lukasHD/74hc595/Board/jlcpcb/production_files/BOM-test_sr.csv

Comment | Designator | Footprint | LCSC
100n | C1,C2,C3 | C_0603_1608Metric | C14663
50R | R1,R2,R3,R4,R5,R6,R7,R8 | R_0603_1608Metric | C23197
10k | R10,R9 | R_0603_1608Metric | C25804
74HC595 | U1 | SOIC-16_4.55x10.3mm_P1.27mm | C5947
LED | D1,D2,D3,D4,D5,D6,D7,D8 | LED_0603_1608Metric | C72041
Conn_01x08 | J2 | PinHeader_1x08_P2.54mm_Vertical
Conn_01x08 | J1 | PinHeader_1x08_P2.54mm_Vertical
