lukasHD/74hc595/Board/test_sr.kicad_pcb

## KiCad design Board/test_sr.kicad_pcb (2023-10-25)

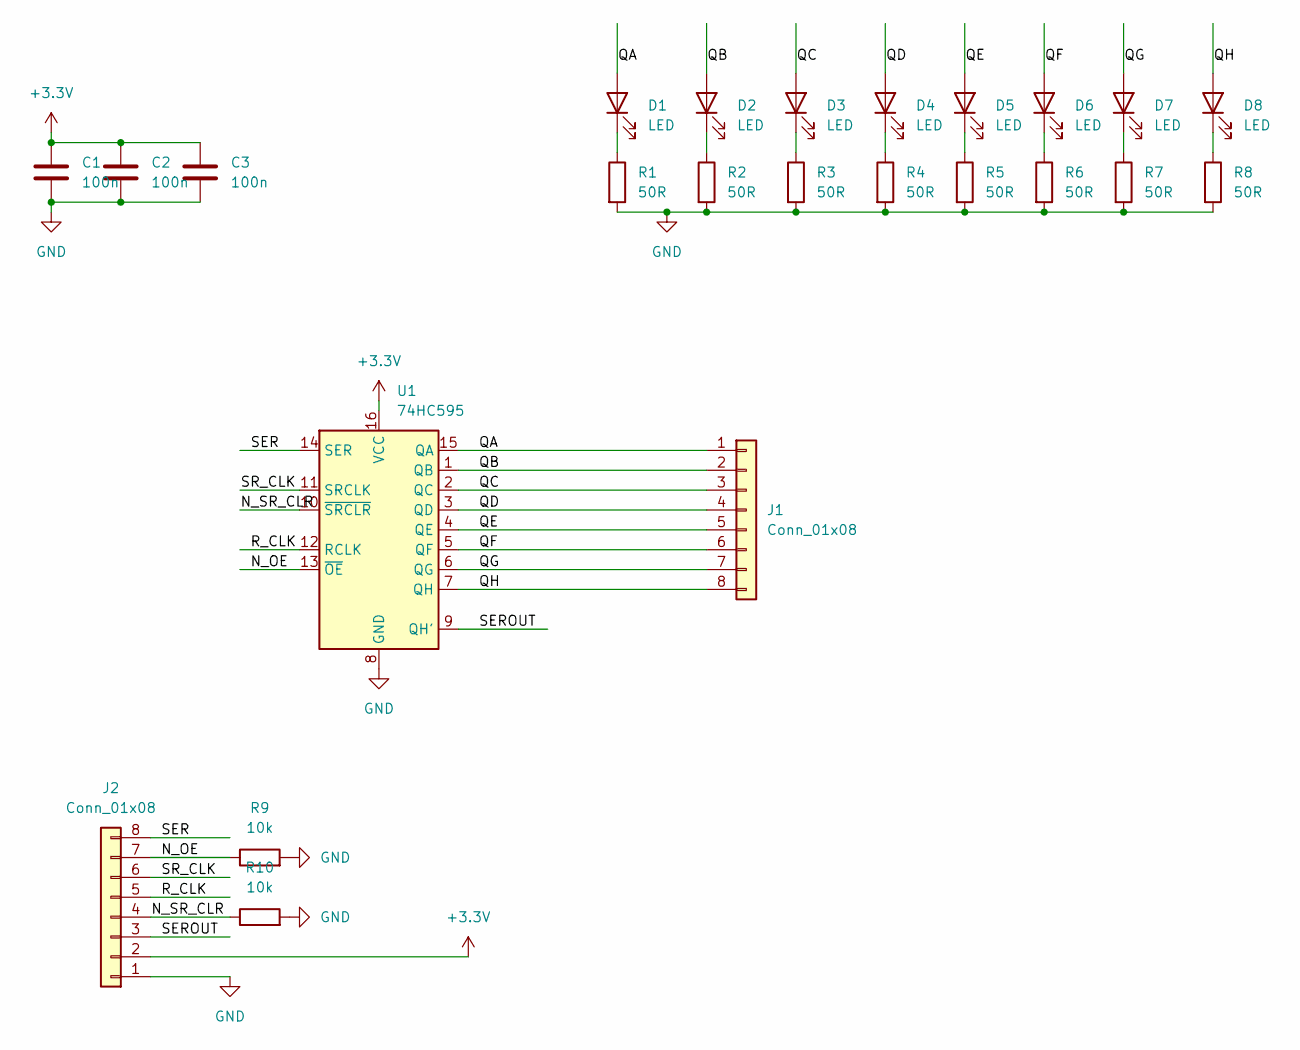
[picture p2: schematic test_sr.kicad_sch]

Parts:
C1, C2, C3: 100n; C_0603_1608Metric; LCSC C14663
D1, D2, D3, D4, D5, D6, D7, D8: LED; LED_0603_1608Metric; LCSC C72041
J1, J2: Conn_01x08; PinHeader_1x08_P2.54mm_Vertical
R1, R2, R3, R4, R5, R6, R7, R8: 50R; R_0603_1608Metric; LCSC C23197
R9, R10: 10k; R_0603_1608Metric; LCSC C25804
U1: 74HC595; SOIC-16_4.55x10.3mm_P1.27mm; LCSC C5947

Connections:
+3.3V: C1.1, C2.1, C3.1, J2.2, U1.16 (VCC)
/N_OE: J2.7, R9.1, U1.13 (~OE)
/N_SR_CLR: J2.4, R10.1, U1.10 (~SRCLR)
/QA: D1.2 (A), J1.1, U1.15 (QA)
/QB: D2.2 (A), J1.2, U1.1 (QB)
/QC: D3.2 (A), J1.3, U1.2 (QC)
/QD: D4.2 (A), J1.4, U1.3 (QD)
/QE: D5.2 (A), J1.5, U1.4 (QE)
/QF: D6.2 (A), J1.6, U1.5 (QF)
/QG: D7.2 (A), J1.7, U1.6 (QG)
/QH: D8.2 (A), J1.8, U1.7 (QH)
/R_CLK: J2.5, U1.12 (RCLK)
/SER: J2.8, U1.14 (SER)
/SEROUT: J2.3, U1.9 (QH')
/SR_CLK: J2.6, U1.11 (SRCLK)
GND: C1.2, C2.2, C3.2, J2.1, R1.2, R2.2, R3.2, R4.2, R5.2, R6.2, R7.2, R8.2, R9.2, R10.2, U1.8 (GND)
unnamed: D1.1 (K), R1.1
unnamed: D2.1 (K), R2.1
unnamed: D3.1 (K), R3.1
unnamed: D4.1 (K), R4.1
unnamed: D5.1 (K), R5.1
unnamed: D6.1 (K), R6.1
unnamed: D7.1 (K), R7.1
unnamed: D8.1 (K), R8.1

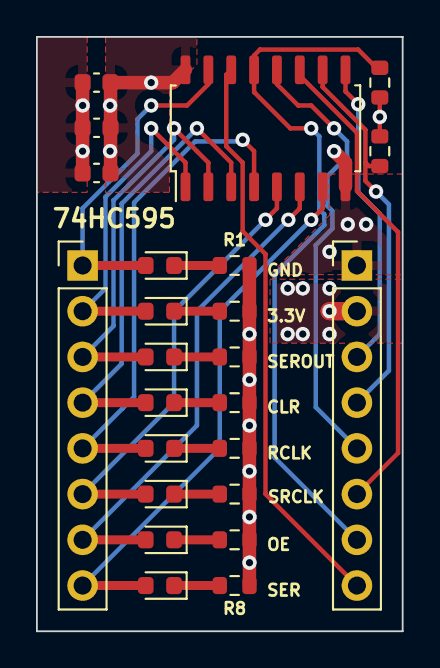
[picture p3: board test_sr.kicad_pcb from above]

Board: 4 copper layers, 20.3 x 33.0 mm, 24 parts (0 on the bottom side), 24 nets.
